drmrs/auto_pen/hardware/images/bottom_feet.jpg

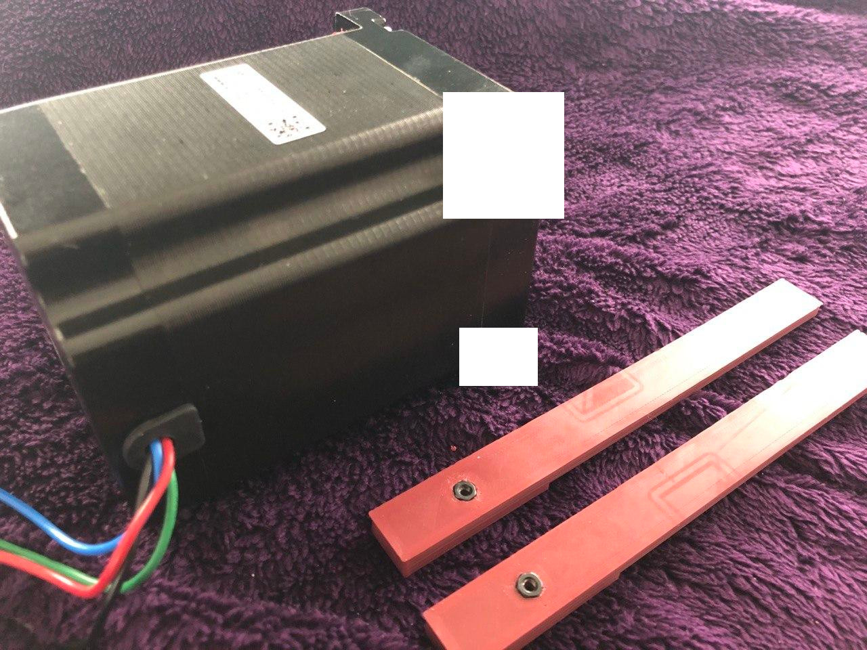
hardware/images/bottom_feet.jpg
