drmrs/auto_pen/hardware/images/main_case_3.png

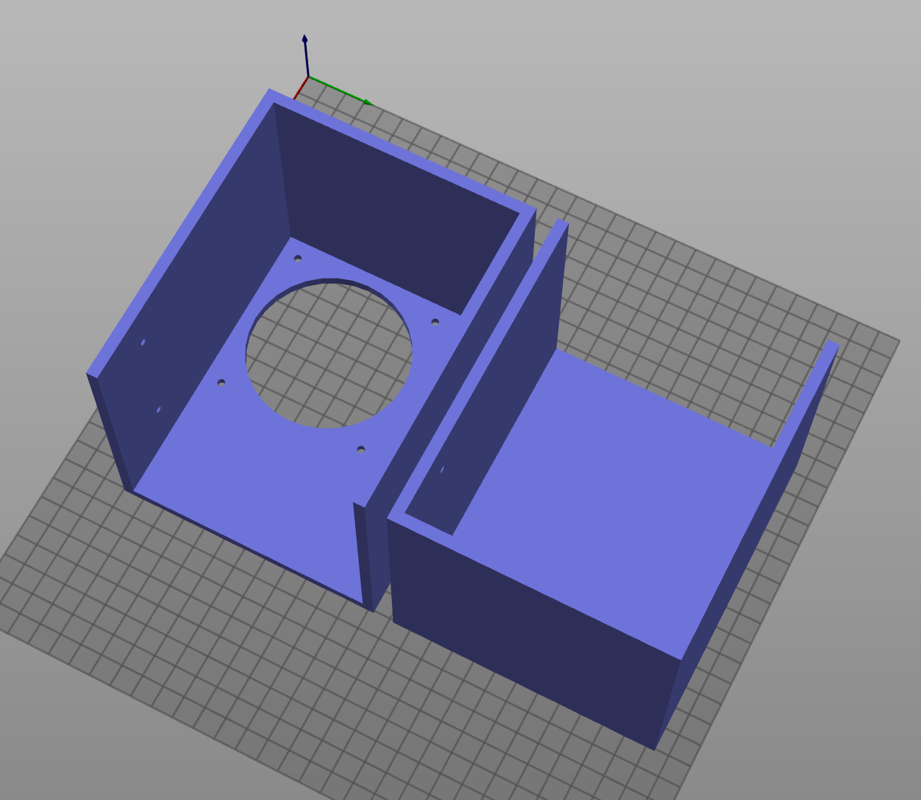
hardware/images/main_case_3.png
