drmrs/auto_pen/hardware/bin/main_body.amf

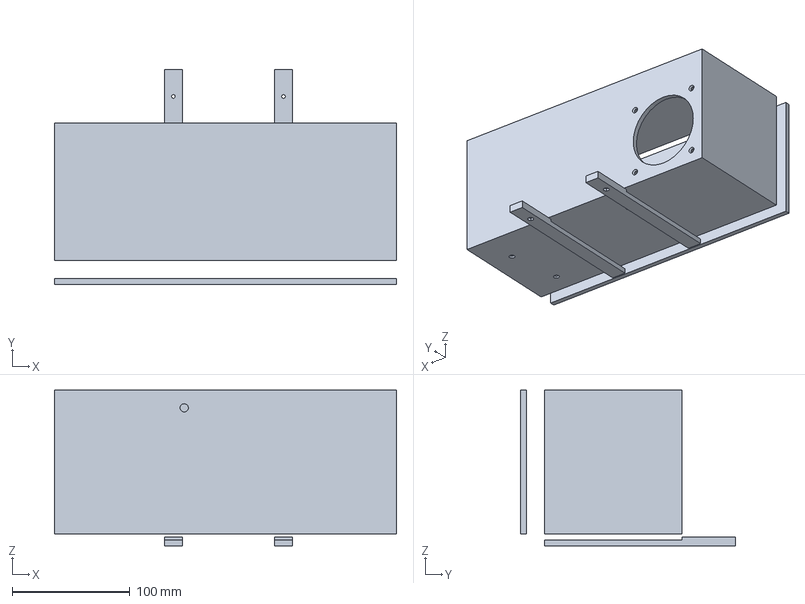
[picture p29: CAD file, 2020-04-01]
hardware/bin/main_body.amf
290.0 x 182.0 x 132.0 mm
