drmrs/auto_pen/hardware/bin/rack_and_pinion.amf

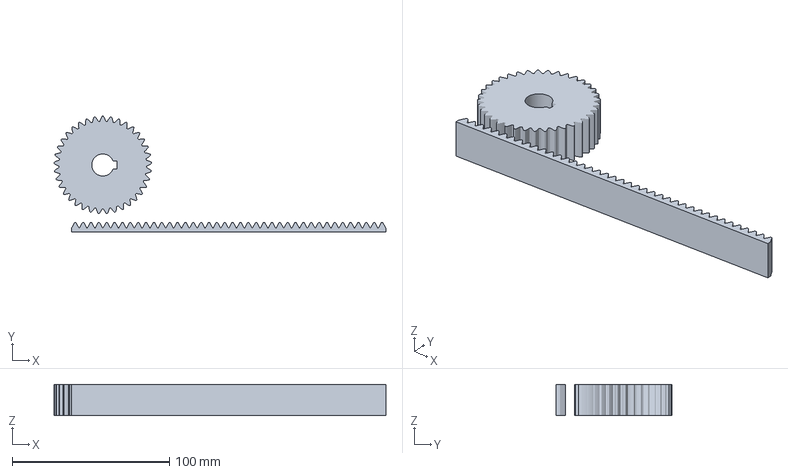
[picture p30: CAD file, 2020-04-01]
hardware/bin/rack_and_pinion.amf
211.0 x 73.5 x 20.0 mm
