drmrs/auto_pen/hardware/bin/rope_pusher_plate.amf

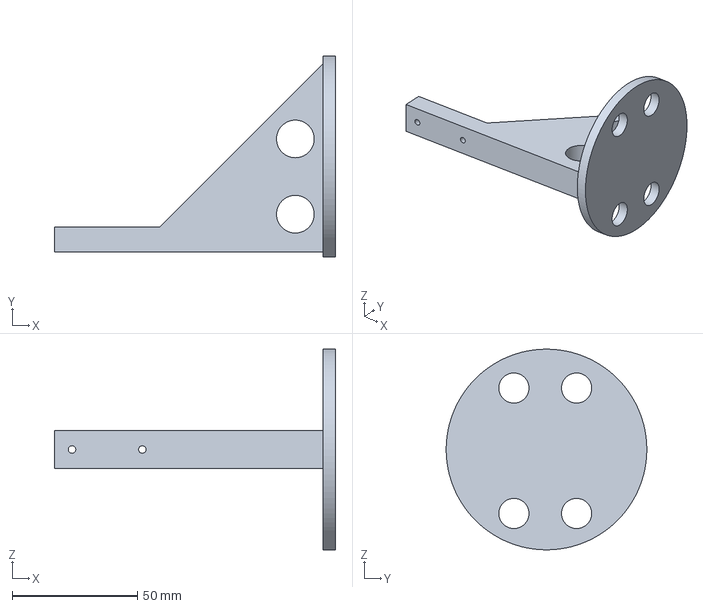
[picture p31: CAD file, 2020-04-01]
hardware/bin/rope_pusher_plate.amf
112.0 x 80.0 x 80.0 mm
