drmrs/auto_pen/hardware/bin/hinge.amf

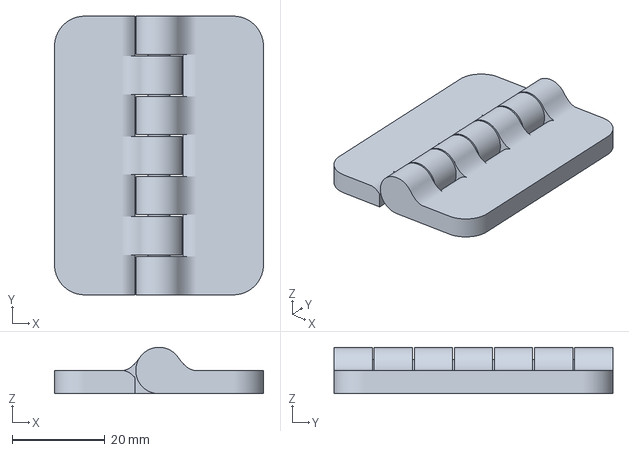
[picture p32: CAD file, 2020-04-01]
hardware/bin/hinge.amf
45.0 x 60.0 x 10.0 mm
