drmrs/auto_pen/hardware/bin/stepper_screw_adapters.amf

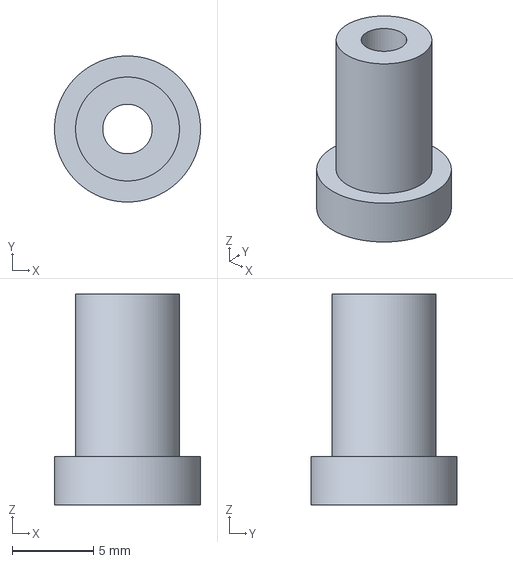
[picture p33: CAD file, 2020-04-01]
hardware/bin/stepper_screw_adapters.amf
9.00 x 9.00 x 13.0 mm
