drmrs/auto_pen/(list of files, cad)

Other CAD files:
hardware/designs/sub_gear.scad
