drmrs/auto_pen/(threads)

Thread 1 (2020-08-26):

Set up a new profile

Tiger1988m, 2020-08-26:
Hi,

can someone help me set up a new profile.
I've build a similar one and it works so far out of the box but I am having a raspberry pi 4
and I also wonder where I can change the depth add new speeds and also change the amount of steps needed for a full round.

I highly appreciate your help!

Thanks & Regards

drmrs, 2020-08-27:
Hello!

https://github.com/drmrs/auto_pen/blob/master/software/auto_pen/cli/configuration.py

Is where profiles live currently.

If you want to create a new profile you could create a new item using `raspberry_pi_1_1600_step_rev_rt` as a template. Assuming you are setup at 1600 steps for a revolution you might call your profile `raspberry_pi_4_1600_step_rev_rt`

Under the speeds you could set the time to sleep between steps to what you like. I might suggest starting adding speeds 5,6,7,8 on top of 1-4 that already exist dropping `step_sleep': 0.00008` to even lower numbers. You need to test these numbers on your pi 4. Remember to update the human descriptions too.

If you need more help you can reach out on a kinky discord server I hang out on. https://discord.gg/9rwcPe

Best wishes.

drmrs, 2020-08-27:
Submit a PR and I'll merge it in.

Tiger1988m, 2020-08-28:
Thank you so much it worked pretty good.
I will make a new profile soon for the Raspberry Pi 4 and also new speeds and send it via PR but it will take probably 2 weeks to do so.

Closed 2020-08-28.

Thread 4 (2021-03-21):

Which motor?

ChilledFaith, 2021-03-21:
The link goes to a 8.5 N.m motor but I also see 12N.m motors, can I use that instead? And is anybody still looking into this? Debating making one and upgrading with a touch screen to control as well as making more attachments. I'm an engineer so I can do the attachments and wiring, but coding is not my strong suit, if anybody wants to help contribute that would be great!

Thread 5 (2023-09-01):

chrt error

daftandhungry, 2023-09-01:
Hi, I recently found this machine on reddit and decided to build it. I had a raspberry pi 3B, nema 23, driverand a 36V PSU laying around.
The software all installed fine, when I use help and configure commands it works, but whenever I try to use the static, random, lock or unlock commands I get an error
chrt: failed to set pid XXX's policy: Operation not permitted

Any ideas on why this may be happening and how I can fix it?

Thanks.

I also modified the case to make it bigger to fit the psu, added an IEC socket and switch instead of the dc jack, a mount for the pi, mounts for two buck converters to lower voltage to run the pi and a couple of 40mm noctua fans.

drmrs, 2023-09-01:
Hey! Run the command as root. Let me know if that works.

Originally I had used a VERY slow raspberry pi gen 1 and I added some stuff behind the scenes to speed things up. Needing to run as root is one of the side effects.

drmrs, 2023-09-01:
Also if you submit a PR I would be happy to upstream your improvements.

daftandhungry, 2023-09-02:
Running as root failed, until I installed again with sudo, no more chrt errors, atm I can't get the motor to move using auto_pen and your gpio setup, I have got the motor to move using a different configuration and code to test the motor actually works and got movement, so I will have to keep playing with it until I can work it out, 3d printing and design, I've got covered, but I know pretty much nothing when it comes to coding for the pi and troubleshooting, I only had the pi for octoprint.
Thanks for your help.

Closed 2023-09-04.
