drmrs/auto_pen/(commit log)

2021-02-06 early v2 designs
    [Rack_and_pinion_v1.1_-with_backboard_endstops_flanges.scad, v2_case.scad]
2021-03-26 case updates
    [v2_atachment.scad, v2_case.scad]
